Art-ut-Kia/8i-8o-arduino-shield/Hardware (Eagle)/ArduinoShield_8i8o.JPG

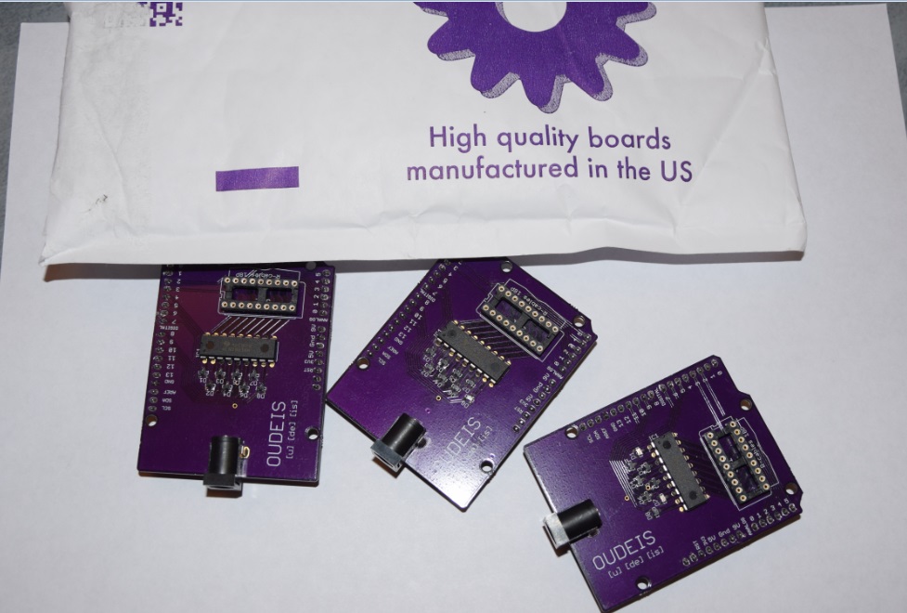
Hardware (Eagle)/ArduinoShield_8i8o.JPG
