Art-ut-Kia/8i-8o-arduino-shield/README.md

# 8i-8o-arduino-shield
Arduino Schield / Reads 8 push-button switches &amp; Drives 8 LED's
