Art-ut-Kia/8i-8o-arduino-shield/Hardware (Eagle)/8i-8o_arduino_shield.png

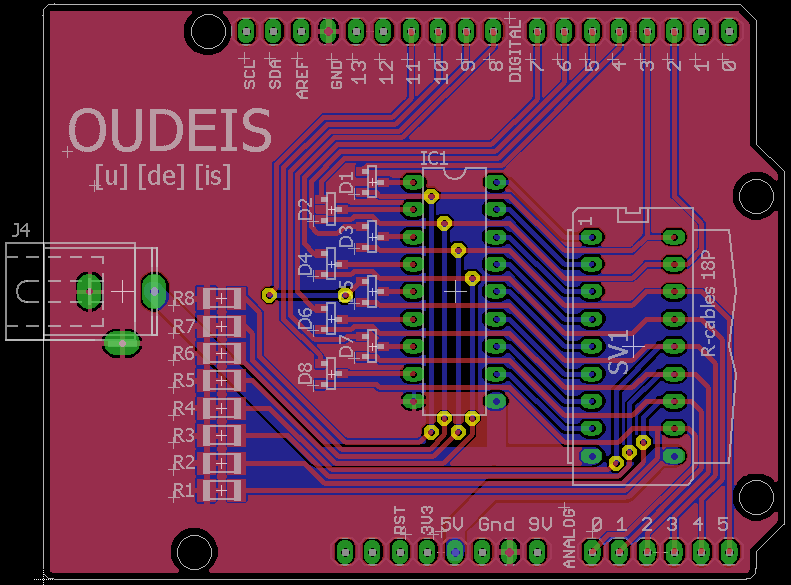
Hardware (Eagle)/8i-8o_arduino_shield.png
