Art-ut-Kia/8i-8o-arduino-shield/Hardware (Eagle)/arduino_8i_8o_Shield.brd

## EAGLE design Hardware (Eagle)/arduino_8i_8o_Shield.brd (2015-10-08)

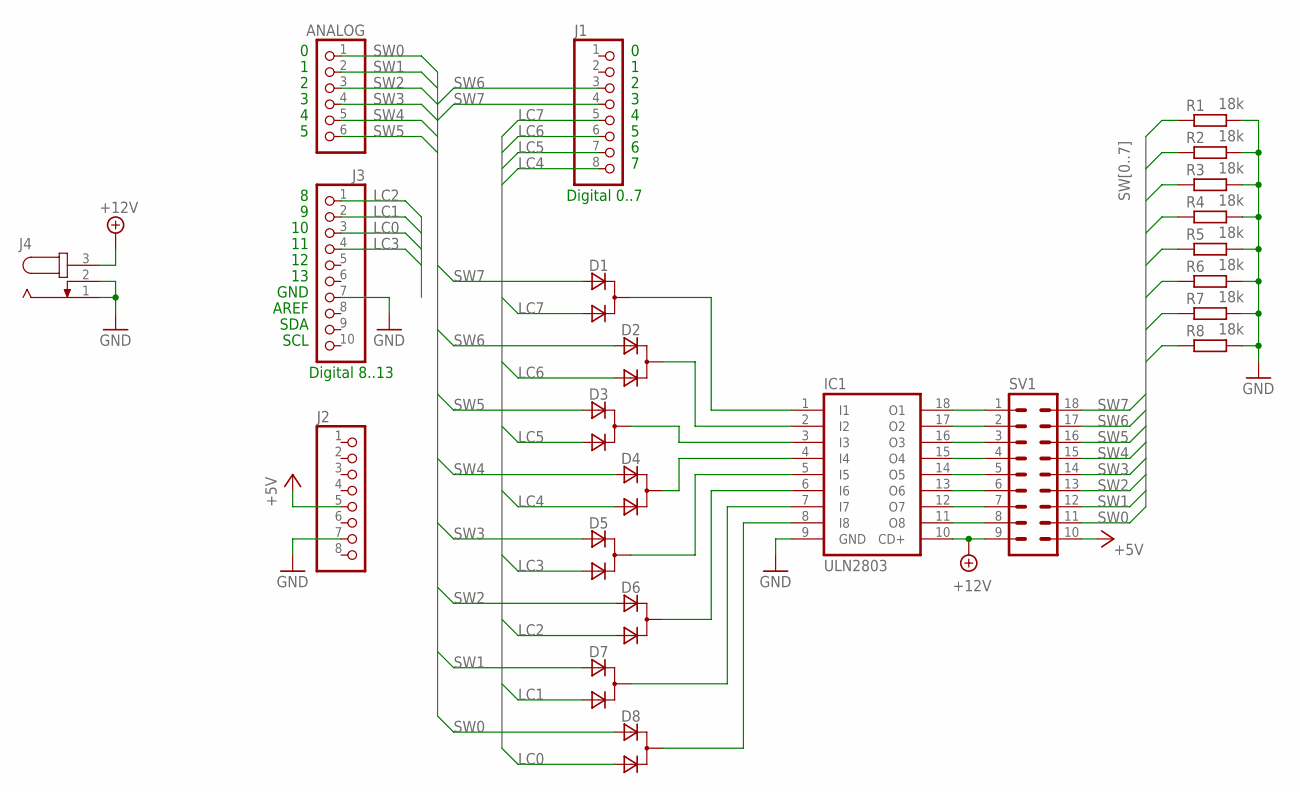
[picture p3: schematic arduino_8i_8o_Shield.sch]

Parts:
ANALOG: PINHD-1X6; 1X06
D1, D2, D3, D4, D5, D6, D7, D8: VAR2_SOT23; SOT-23
IC1: ULN2803; DIL18
J1, J2: PINHD-1X8TH; 1X08-TH
J3: PINHD-1X10TH; 1X10-TH
J4: JACK-PLUG0; SPC4077
R1, R2, R3, R4, R5, R6, R7, R8: 18k; M1206
SV1: IC18PL

Connections:
+5V: J2.5, SV1.10
+12V: IC1.10 (CD+), J4.3, SV1.9
GND: IC1.9 (GND), J2.7, J3.7, J4.1, J4.2, R1.2, R2.2, R3.2, R4.2, R5.2, R6.2, R7.2, R8.2
LC0: D8.3 (A2), J3.3
LC1: D7.3 (A2), J3.2
LC2: D6.3 (A2), J3.1
LC3: D5.3 (A2), J3.4
LC4: D4.3 (A2), J1.8
LC5: D3.3 (A2), J1.7
LC6: D2.3 (A2), J1.6
LC7: D1.3 (A2), J1.5
unnamed: IC1.11 (O8), SV1.8
unnamed: IC1.18 (O1), SV1.1
unnamed: IC1.17 (O2), SV1.2
unnamed: IC1.16 (O3), SV1.3
unnamed: IC1.15 (O4), SV1.4
unnamed: IC1.14 (O5), SV1.5
unnamed: IC1.13 (O6), SV1.6
unnamed: IC1.12 (O7), SV1.7
unnamed: D1.1 (C), IC1.1 (I1)
unnamed: D2.1 (C), IC1.2 (I2)
unnamed: D3.1 (C), IC1.3 (I3)
unnamed: D4.1 (C), IC1.4 (I4)
unnamed: D5.1 (C), IC1.5 (I5)
unnamed: D6.1 (C), IC1.6 (I6)
unnamed: D7.1 (C), IC1.7 (I7)
unnamed: D8.1 (C), IC1.8 (I8)
SW0: ANALOG.1, D8.2 (A1), R1.1, SV1.11
SW1: ANALOG.2, D7.2 (A1), R2.1, SV1.12
SW2: ANALOG.3, D6.2 (A1), R3.1, SV1.13
SW3: ANALOG.4, D5.2 (A1), R4.1, SV1.14
SW4: ANALOG.5, D4.2 (A1), R5.1, SV1.15
SW5: ANALOG.6, D3.2 (A1), R6.1, SV1.16
SW6: D2.2 (A1), J1.3, R7.1, SV1.17
SW7: D1.2 (A1), J1.4, R8.1, SV1.18

Notes on the sheet:
Digital 0..7
Digital 8..13
GND
AREF
SDA
SCL

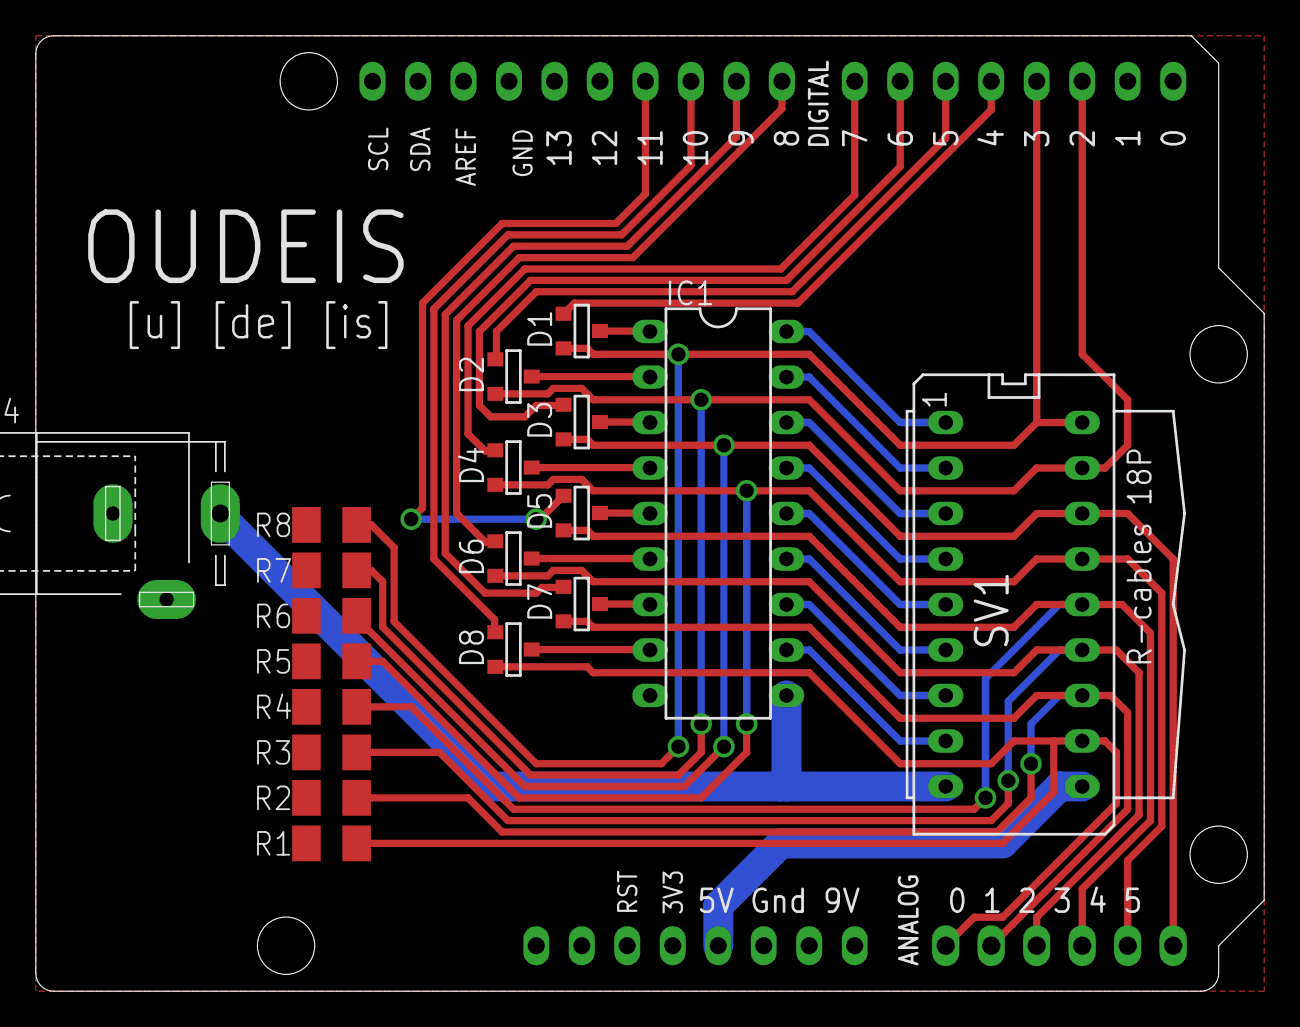
[picture p4: board arduino_8i_8o_Shield.brd from above]

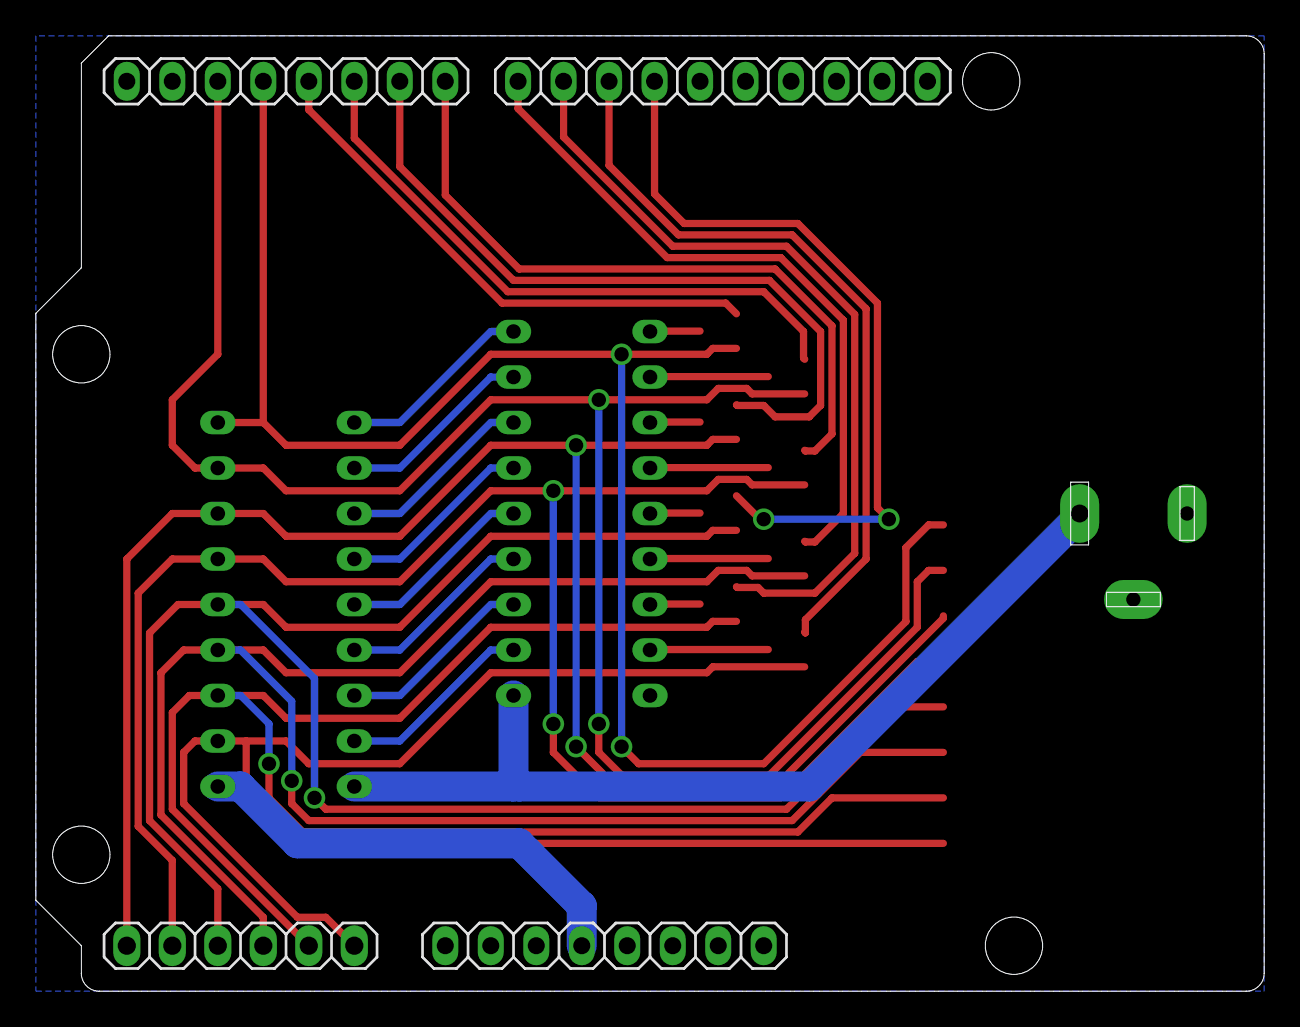
[picture p5: board arduino_8i_8o_Shield.brd from below]

Board: 2 copper layers, 68.6 x 53.3 mm, 23 parts (4 on the bottom side), 35 nets.
