Art-ut-Kia/8i-8o-arduino-shield/(commit log)

2015-10-04 Added Eagle Files + a Picture of 3 freshly assembled boards
    This arduino shield reads 8 push-button switches and controls 8 LED's
    [arduino_8i_8o_Shield.brd, arduino_8i_8o_Shield.sch]
2015-10-04 Revert "Added Eagle Files + a Picture of 3 freshly assembled boards"
    This reverts commit d92fc356f843c7ef5f3d70934b7907950014cf2e.
    [arduino_8i_8o_Shield.brd, arduino_8i_8o_Shield.sch]
2015-10-04 Revert "Revert "Added Eagle Files + a Picture of 3 freshly assembled boards""
    This reverts commit cff66f8e90e7c38e4805cda6485667aeac220695.
    [arduino_8i_8o_Shield.brd, arduino_8i_8o_Shield.sch]
2015-10-08 Added 8 x 18k pull-down resistors on switches inputs
    The absence of these resistors induced a cross talk between LED output
    and switches reading inputs
    [arduino_8i_8o_Shield.brd, arduino_8i_8o_Shield.sch]
2015-10-08 Reajusted the logo position ; Added a screen copy of the board design
    Cosmetic changes
    [arduino_8i_8o_Shield.brd]
2015-10-09 Added a binary version of arduino sketch
    This version of sketch transmits an octet at any change in the 8
    switches statuses (one switch status per bit). In the same way, all 8 x
    LEDs are commanded simultaneously by a single octet.
